emin3397/EE464-Project/README.md

# EE464-Project
Emin Ün-Emre Karabakla-Görkem Gülletutan

Rapor: 
https://docs.google.com/document/d/1F6ZsHuH_-bDFWWwnSLHJ_5yXT3tPWivFNy6Llo1I6zs/edit#heading=h.hhpnnwzfyg3q

Sunum:
https://docs.google.com/presentation/d/1tMdv5Q-z6gMAUCtrlJFETEWXZ9VnNtSR/edit#slide=id.p1
