emin3397/EE464-Project/PCB/main/main-Edge_Cuts.dxf

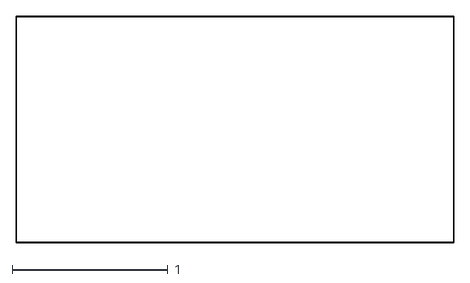
[picture p25: CAD file, 2021-05-06]
PCB/main/main-Edge_Cuts.dxf
2.81 x 1.45
