emin3397/EE464-Project/PCB/main_backup/main-B_Cu.dxf

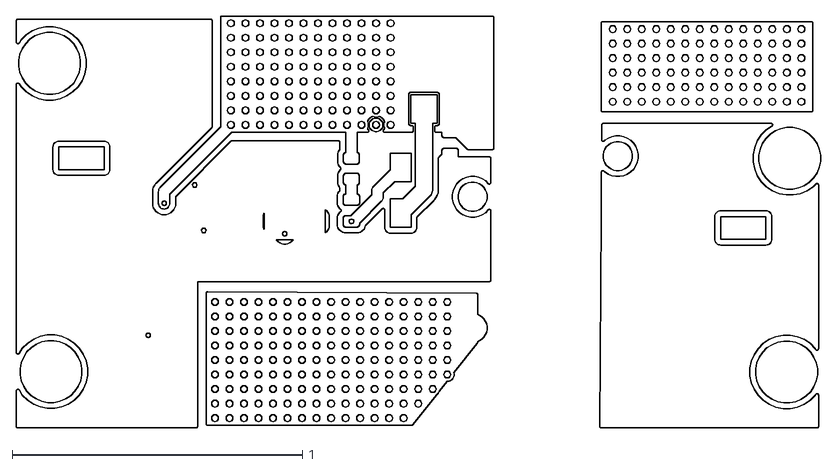
[picture p26: CAD file, 2021-05-06]
PCB/main_backup/main-B_Cu.dxf
2.77 x 1.42
