emin3397/EE464-Project/PCB/main/main-F_Cu.dxf

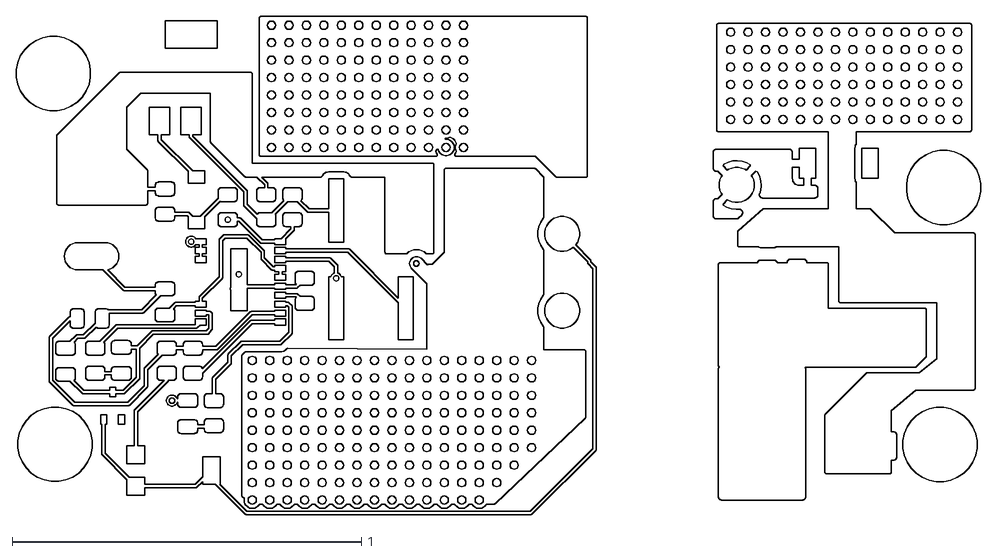
[picture p27: CAD file, 2021-05-06]
PCB/main/main-F_Cu.dxf
2.76 x 1.43
