emin3397/EE464-Project/PCB/main/solidworks/full_montaj.SLDASM

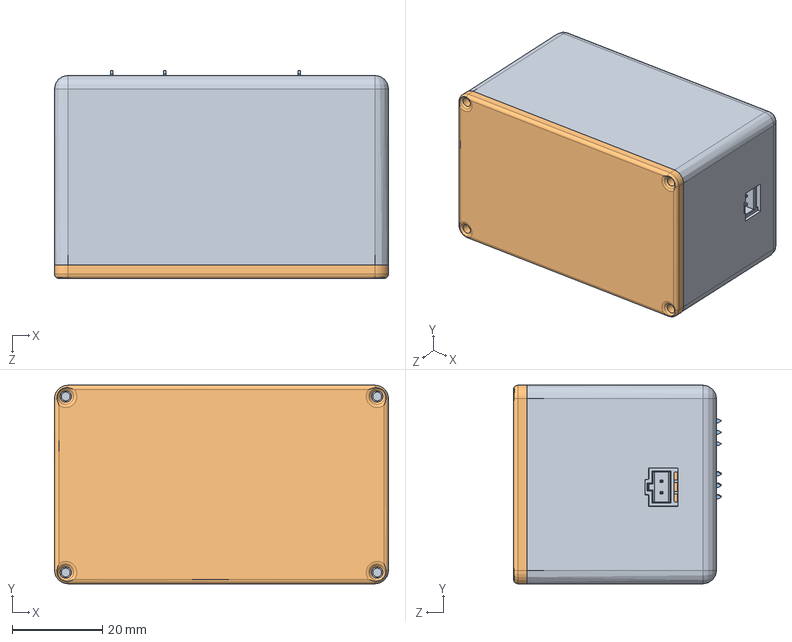
[picture p28: CAD file, 2021-07-01]
PCB/main/solidworks/full_montaj.SLDASM
74.0 x 44.0 x 46.1 mm
COMPOUND.step x 2
SOLID.step x 3
SOLID-0.step x 9
SOLID-1.step
SOLID-2.step
SOLID-3.step
SOLID-4.step x 11
SOLID-5.step
SOLID-6.step x 8
COMPOUND-7.step
SOLID-8.step
SOLID-9.step
SOLID-10.step
SOLID-11.step
COMPOUND-12.step
power_connector x 2
