emin3397/EE464-Project/PCB/main/solidworks/main.SLDASM

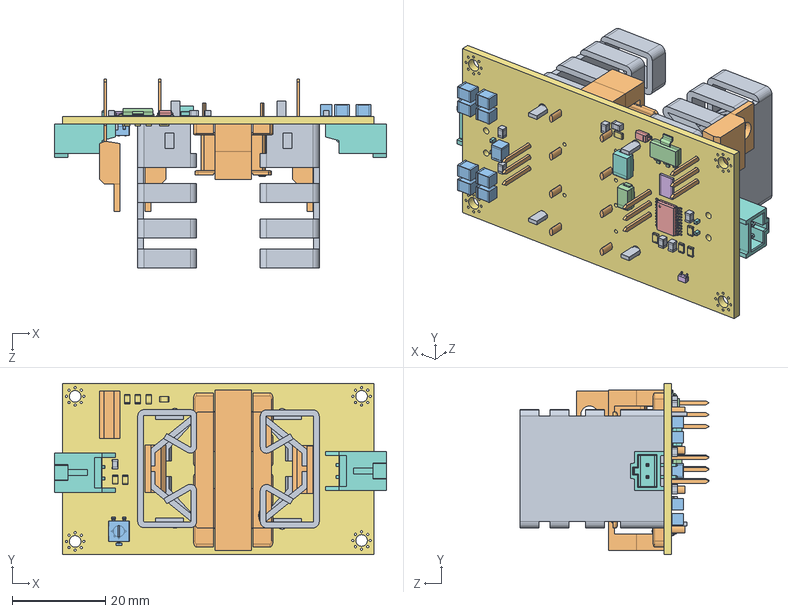
[picture p29: CAD file, 2021-07-01]
PCB/main/solidworks/main.SLDASM
71.4 x 36.8 x 40.8 mm
COMPOUND.step x 2
SOLID.step x 3
SOLID-0.step x 9
SOLID-1.step
SOLID-2.step
SOLID-3.step
SOLID-4.step x 11
SOLID-5.step
SOLID-6.step x 8
COMPOUND-7.step
SOLID-8.step
SOLID-9.step
SOLID-10.step
SOLID-11.step
COMPOUND-12.step
power_connector x 2
