emin3397/EE464-Project/PCB/main_backup/solidworks/full_copper.SLDASM

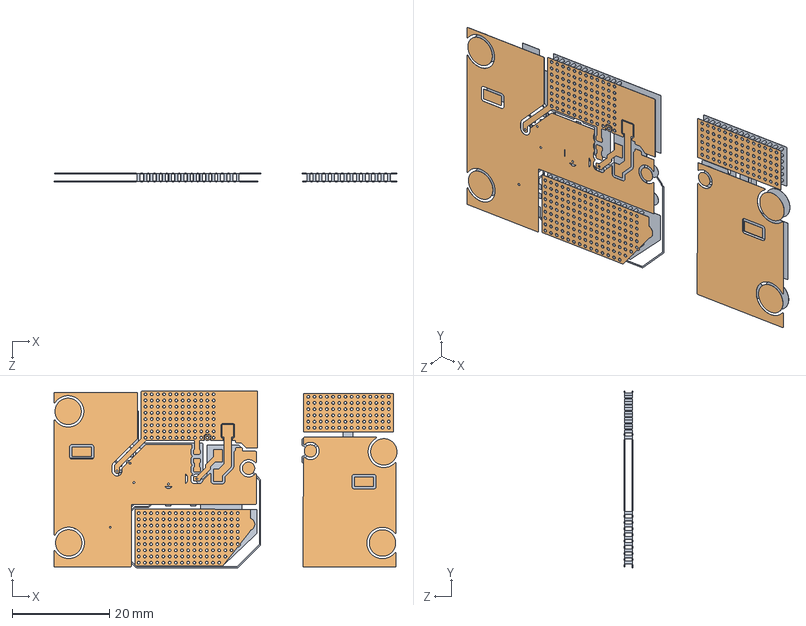
[picture p30: CAD file, 2021-05-06]
PCB/main_backup/solidworks/full_copper.SLDASM
70.4 x 36.2 x 1.67 mm
Front_copper
Back_copper
