emin3397/EE464-Project/PCB/main_backup/solidworks/main.SLDASM

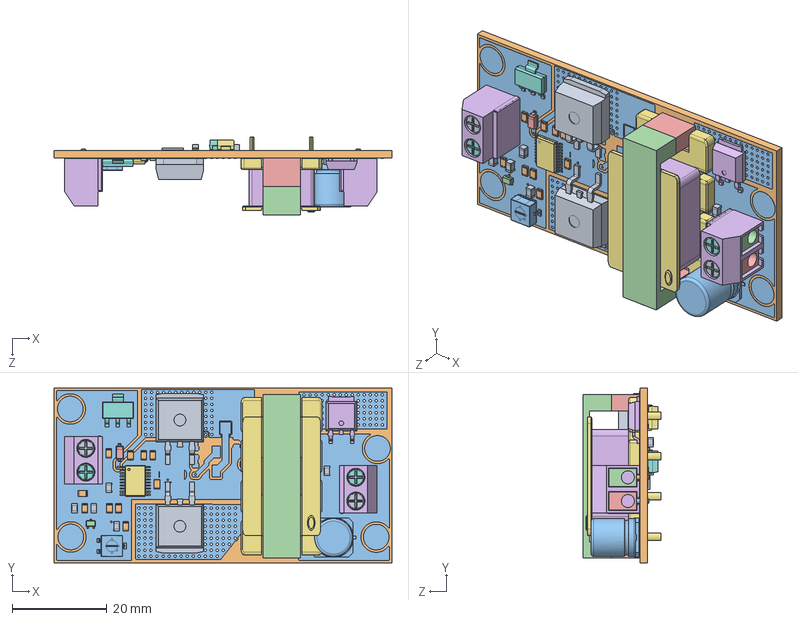
[picture p31: CAD file, 2021-05-06]
PCB/main_backup/solidworks/main.SLDASM
71.2 x 36.8 x 16.4 mm
full_copper
