emin3397/EE464-Project/PCB/main/solidworks/box.SLDPRT

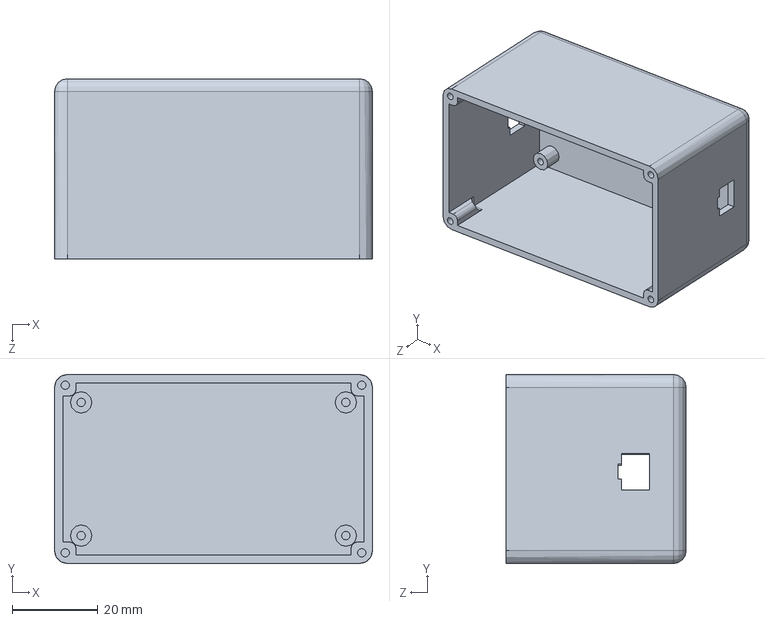
[picture p32: CAD file, 2021-07-01]
PCB/main/solidworks/box.SLDPRT
74.0 x 44.0 x 42.0 mm
