emin3397/EE464-Project/PCB/power_connector.stp

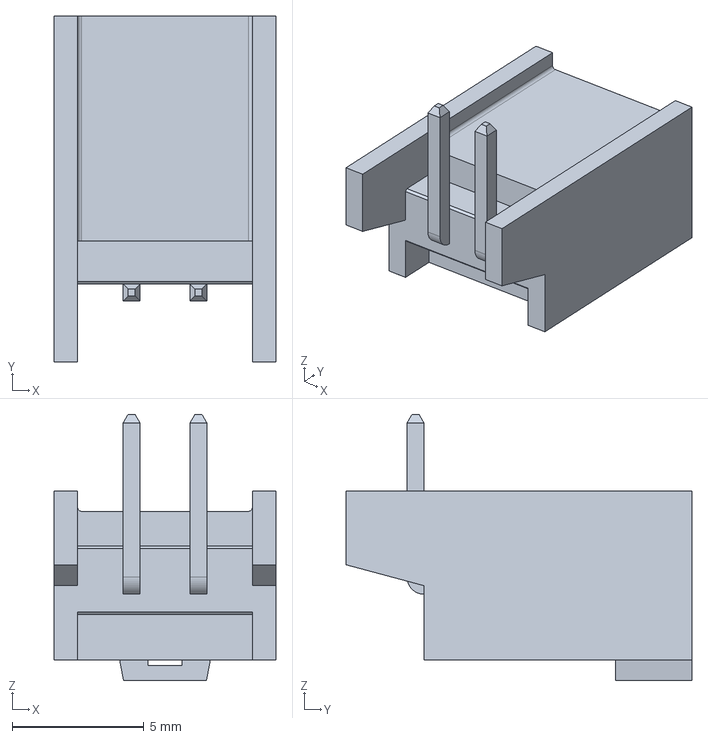
[picture p33: CAD file, 2021-07-01]
PCB/power_connector.stp
8.43 x 13.1 x 10.1 mm
