emin3397/EE464-Project/PCB/fk_241_sa_218_v.stp

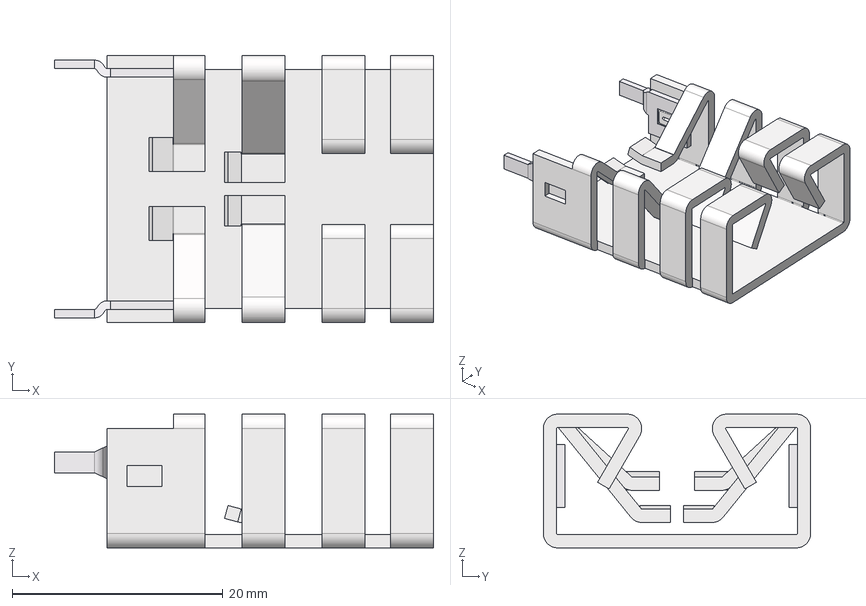
[picture p34: CAD file, 2021-05-06]
PCB/fk_241_sa_218_v.stp
36.0 x 25.4 x 12.7 mm
