emin3397/EE464-Project/PCB/main/solidworks/box_lid.SLDPRT

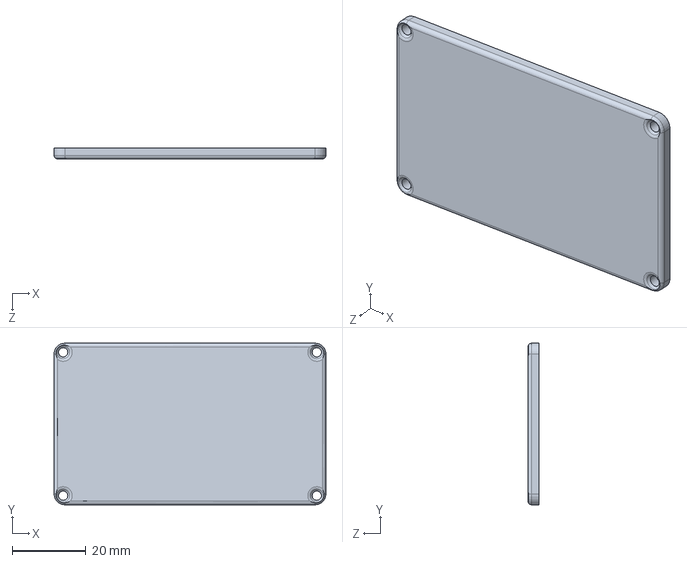
[picture p35: CAD file, 2021-07-01]
PCB/main/solidworks/box_lid.SLDPRT
74.0 x 44.0 x 3.00 mm
