emin3397/EE464-Project/PCB/Transformer.STEP

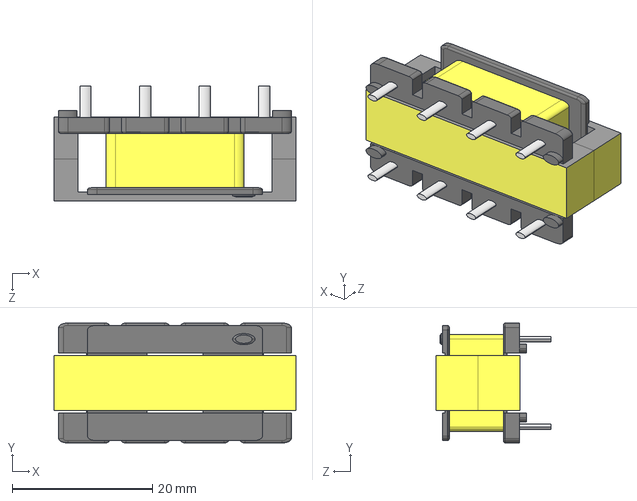
[picture p36: CAD file, 2021-05-01]
PCB/Transformer.STEP
34.5 x 17.1 x 16.4 mm
