emin3397/EE464-Project/PCB/main_backup/solidworks/COMPOUND.SLDPRT

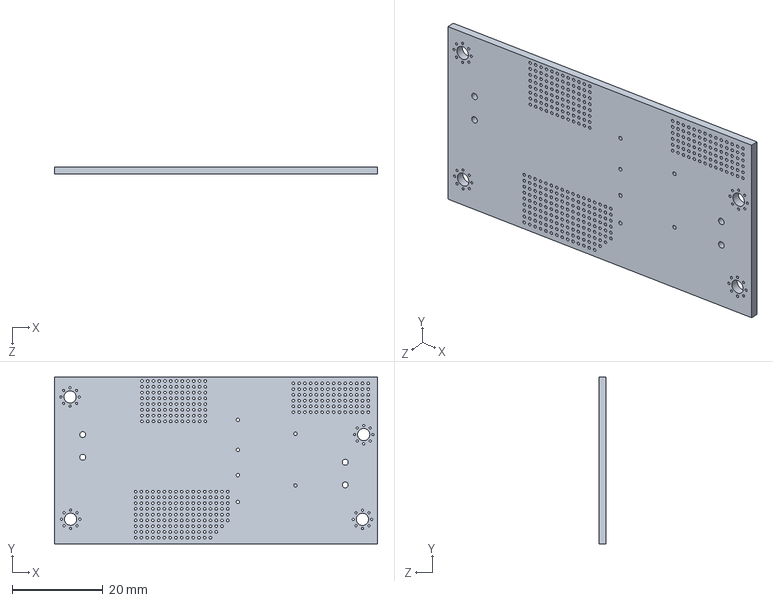
[picture p37: CAD file, 2021-05-06]
PCB/main_backup/solidworks/COMPOUND.SLDPRT
71.2 x 36.8 x 1.60 mm
