emin3397/EE464-Project/PCB/main_backup/solidworks/Front_copper.SLDPRT

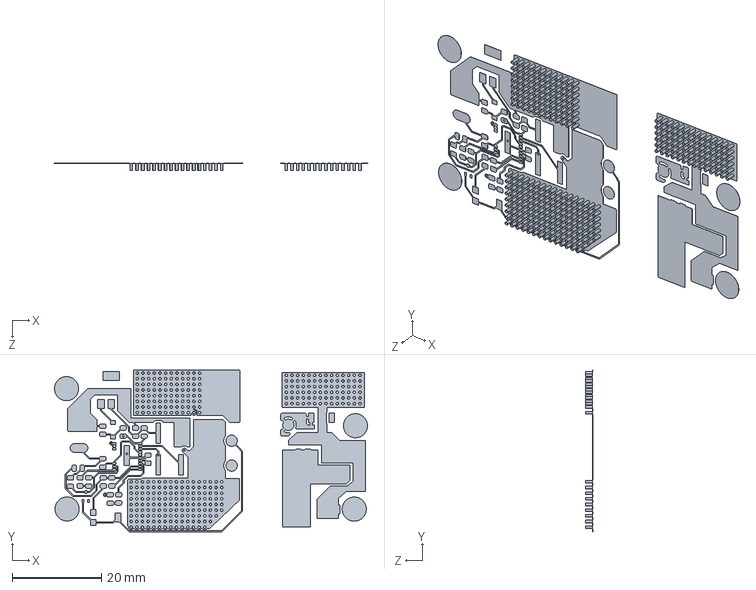
[picture p38: CAD file, 2021-05-06]
PCB/main_backup/solidworks/Front_copper.SLDPRT
70.2 x 36.2 x 1.67 mm
