emin3397/EE464-Project/PCB/main_backup/solidworks/Back_copper.SLDPRT

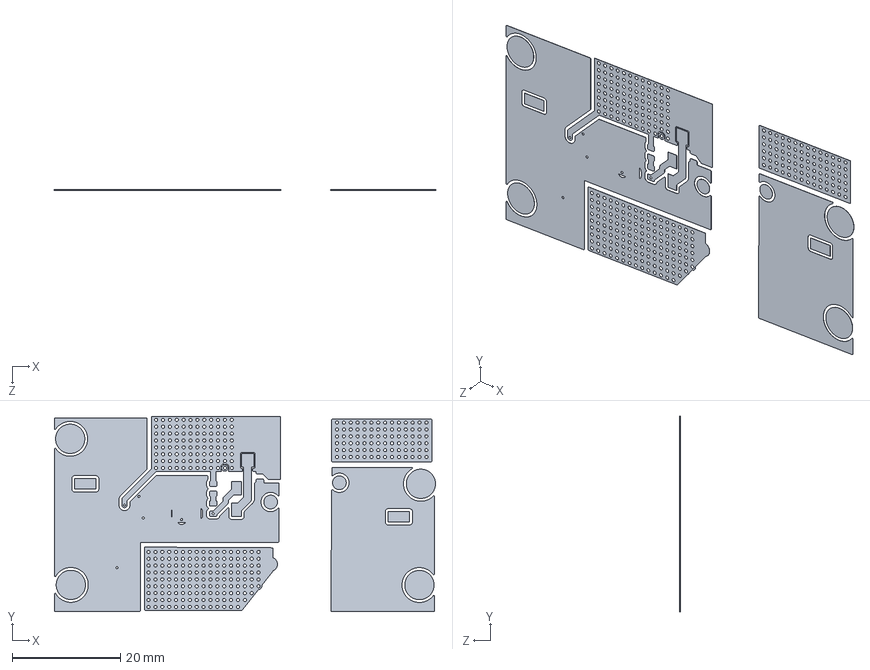
[picture p39: CAD file, 2021-05-06]
PCB/main_backup/solidworks/Back_copper.SLDPRT
70.4 x 36.0 x 0.035 mm
