emin3397/EE464-Project/(list of files, cad)

Other CAD files:
PCB/main_backup/solidworks/SOT-223.SLDASM
PCB/main_backup/solidworks/D_SOD-123.SLDASM
PCB/main_backup/solidworks/C_Elec_8x10.2-subassembly-1.SLDASM
PCB/main_backup/solidworks/Potentiometer_Bourns_3314G_Vertical.SLDASM
PCB/main_backup/solidworks/Transformer.SLDASM
PCB/main_backup/solidworks/Transformer-subassembly-1.SLDASM
PCB/main_backup/solidworks/SOT-323_SC-70.SLDASM
PCB/main_backup/solidworks/R_1218_3246Metric.SLDASM
PCB/main_backup/solidworks/C_0805_2012Metric.SLDASM
PCB/main_backup/solidworks/D_SMA.SLDASM
PCB/main_backup/solidworks/TO-252-2.SLDASM
PCB/main_backup/solidworks/C_Elec_8x10.2.SLDASM
PCB/main_backup/solidworks/R_0805_2012Metric.SLDASM
PCB/main_backup/solidworks/TSSOP-20_4.4x6.5mm_P0.65mm.SLDASM
PCB/main_backup/solidworks/D_SMB.SLDASM
PCB/main_backup/solidworks/TO-263-2.SLDASM
PCB/main_backup/solidworks/COMPOUND-5.SLDPRT
PCB/main_backup/solidworks/COMPOUND-8.SLDPRT
PCB/main_backup/solidworks/SOLID-9.SLDPRT
PCB/main/solidworks/power_connector.SLDPRT
PCB/main_backup/solidworks/SOLID-7.SLDPRT
PCB/main_backup/solidworks/COMPOUND-4.SLDPRT
PCB/main_backup/solidworks/COMPOUND-9.SLDPRT
PCB/main_backup/solidworks/COMPOUND-13.SLDPRT
PCB/main_backup/solidworks/COMPOUND-12.SLDPRT
PCB/main_backup/solidworks/COMPOUND-6.SLDPRT
PCB/main_backup/solidworks/SOLID-4.SLDPRT
PCB/main_backup/solidworks/COMPOUND-3.SLDPRT
PCB/main_backup/solidworks/COMPOUND-2.SLDPRT
PCB/main_backup/solidworks/SOLID-8.SLDPRT
PCB/main_backup/solidworks/SOLID.SLDPRT
PCB/main_backup/solidworks/SOLID-3.SLDPRT
PCB/main_backup/solidworks/SOLID-1.SLDPRT
PCB/main_backup/solidworks/SOLID-2.SLDPRT
PCB/main_backup/solidworks/SOLID-11.SLDPRT
PCB/main_backup/solidworks/COMPOUND-7.SLDPRT
PCB/main_backup/solidworks/COMPOUND-1.SLDPRT
PCB/main_backup/solidworks/SOLID-6.SLDPRT
PCB/main_backup/solidworks/COMPOUND-10.SLDPRT
PCB/main_backup/solidworks/COMPOUND-11.SLDPRT
PCB/main_backup/solidworks/SOLID-10.SLDPRT
PCB/main_backup/solidworks/SOLID-5.SLDPRT
PCB/main/main-B_Mask.dxf
PCB/main/main-B_Paste.dxf
PCB/main/main-B_SilkS.dxf
PCB/main/main-F_Mask.dxf
PCB/main/main-F_Paste.dxf
PCB/main/main-F_SilkS.dxf
PCB/main/solidworks_old/COMPOUND-1.SLDPRT
PCB/main/solidworks_old/COMPOUND-10.SLDPRT
PCB/main/solidworks_old/COMPOUND-11.SLDPRT
PCB/main/solidworks_old/COMPOUND-12.SLDPRT
PCB/main/solidworks_old/COMPOUND-13.SLDPRT
PCB/main/solidworks_old/COMPOUND-2.SLDPRT
PCB/main/solidworks_old/COMPOUND-3.SLDPRT
PCB/main/solidworks_old/COMPOUND-4.SLDPRT
PCB/main/solidworks_old/COMPOUND-5.SLDPRT
PCB/main/solidworks_old/COMPOUND-6.SLDPRT
PCB/main/solidworks_old/COMPOUND-7.SLDPRT
PCB/main/solidworks_old/COMPOUND-8.SLDPRT
PCB/main/solidworks_old/COMPOUND-9.SLDPRT
PCB/main/solidworks_old/C_0805_2012Metric.SLDASM
PCB/main/solidworks_old/C_Elec_8x10.2-subassembly-1.SLDASM
PCB/main/solidworks_old/C_Elec_8x10.2.SLDASM
PCB/main/solidworks_old/D_SMA.SLDASM
PCB/main/solidworks_old/D_SMB.SLDASM
PCB/main/solidworks_old/D_SOD-123.SLDASM
PCB/main/solidworks_old/Potentiometer_Bourns_3314G_Vertical.SLDASM
PCB/main/solidworks_old/R_0805_2012Metric.SLDASM
PCB/main/solidworks_old/R_1218_3246Metric.SLDASM
PCB/main/solidworks_old/SOLID-1.SLDPRT
PCB/main/solidworks_old/SOLID-10.SLDPRT
PCB/main/solidworks_old/SOLID-11.SLDPRT
PCB/main/solidworks_old/SOLID-2.SLDPRT
PCB/main/solidworks_old/SOLID-3.SLDPRT
PCB/main/solidworks_old/SOLID-4.SLDPRT
PCB/main/solidworks_old/SOLID-5.SLDPRT
PCB/main/solidworks_old/SOLID-6.SLDPRT
PCB/main/solidworks_old/SOLID-7.SLDPRT
PCB/main/solidworks_old/SOLID-8.SLDPRT
PCB/main/solidworks_old/SOLID-9.SLDPRT
PCB/main/solidworks_old/SOLID.SLDPRT
PCB/main/solidworks_old/SOT-223.SLDASM
PCB/main/solidworks_old/SOT-323_SC-70.SLDASM
PCB/main/solidworks_old/Screw_Terminal_Block_5mm_2-way-subassembly-1.SLDASM
PCB/main/solidworks_old/Screw_Terminal_Block_5mm_2-way.SLDASM
PCB/main/solidworks_old/TO-252-2.SLDASM
PCB/main/solidworks_old/TO-263-2.SLDASM
PCB/main/solidworks_old/TSSOP-20_4.4x6.5mm_P0.65mm.SLDASM
PCB/main/solidworks_old/Transformer-subassembly-1.SLDASM
PCB/main/solidworks_old/Transformer.SLDASM
PCB/main_backup/main-B_Mask.dxf
PCB/main_backup/main-B_Paste.dxf
PCB/main_backup/main-B_SilkS.dxf
PCB/main_backup/main-F_Mask.dxf
PCB/main_backup/main-F_Paste.dxf
PCB/main_backup/main-F_SilkS.dxf
PCB/main_backup/solidworks/Screw_Terminal_Block_5mm_2-way-subassembly-1.SLDASM
PCB/main_backup/solidworks/Screw_Terminal_Block_5mm_2-way.SLDASM
