emin3397/EE464-Project/PCB/main/solidworks/PerformanceLog.txt

Number of Contacts: 2
Number of contact data: 8265
