emin3397/EE464-Project/PCB/main_backup/solidworks/PerformanceLog.txt

Number of Contacts: 3
Number of contact data: 8403
