emin3397/EE464-Project/Circuits/Flyback_LT8316.asc

C1: cap; 100nf
C3: cap; 47p; Rser=10K
C5: cap; 1µ
C7: cap; 1n; Rser=25
C8: cap; 200µ; Rser=2m
C9: cap; 100n; Rser=20K
D2: schottky; RB058L150
D3: diode; STD12100TR
D4: diode; RFN1L7S
D5: zener; 1N5378B; N=2
L1: ind2; 380µ; Rser=0.5
L2: ind2; 2.63µ; Rser=0.03 Cpar=0.5p
L3: ind2; 2.63µ; Rser=0.6
M1: NMOS; IPU80R2K8CEBKMA1
M2: NMOS; BSB012N03LX3
R4: res; 108K
R5: res; 18.7k
R6: res; 2.2k
R9: res; 61.9K
Rload1: res; 1.55
Rload: res; 14.4
Rsense: res; 20m
U1: LT8316
Vin1: voltage; PULSE(0 12 25m 1p 1p 5m 10m)
Vin: voltage; 400
Named nets: 0, IN, OUT, G, D, S
K1 L1 L2 L3 0.993
12:1:1
.tran 20m 40m 0 20u startup uic
.model STD12100TR D(Vrev=100 Vf=0.75)
.model IPU80R2K8CEBKMA1 VDMOS(Rg=1.2 Cjo=.29n Vds=800 Ron=2.8 Qg=12n)
.model SW SW()
