emin3397/EE464-Project/PCB/main/main.kicad_pcb

## KiCad design PCB/main/main.kicad_pcb (2021-07-01)

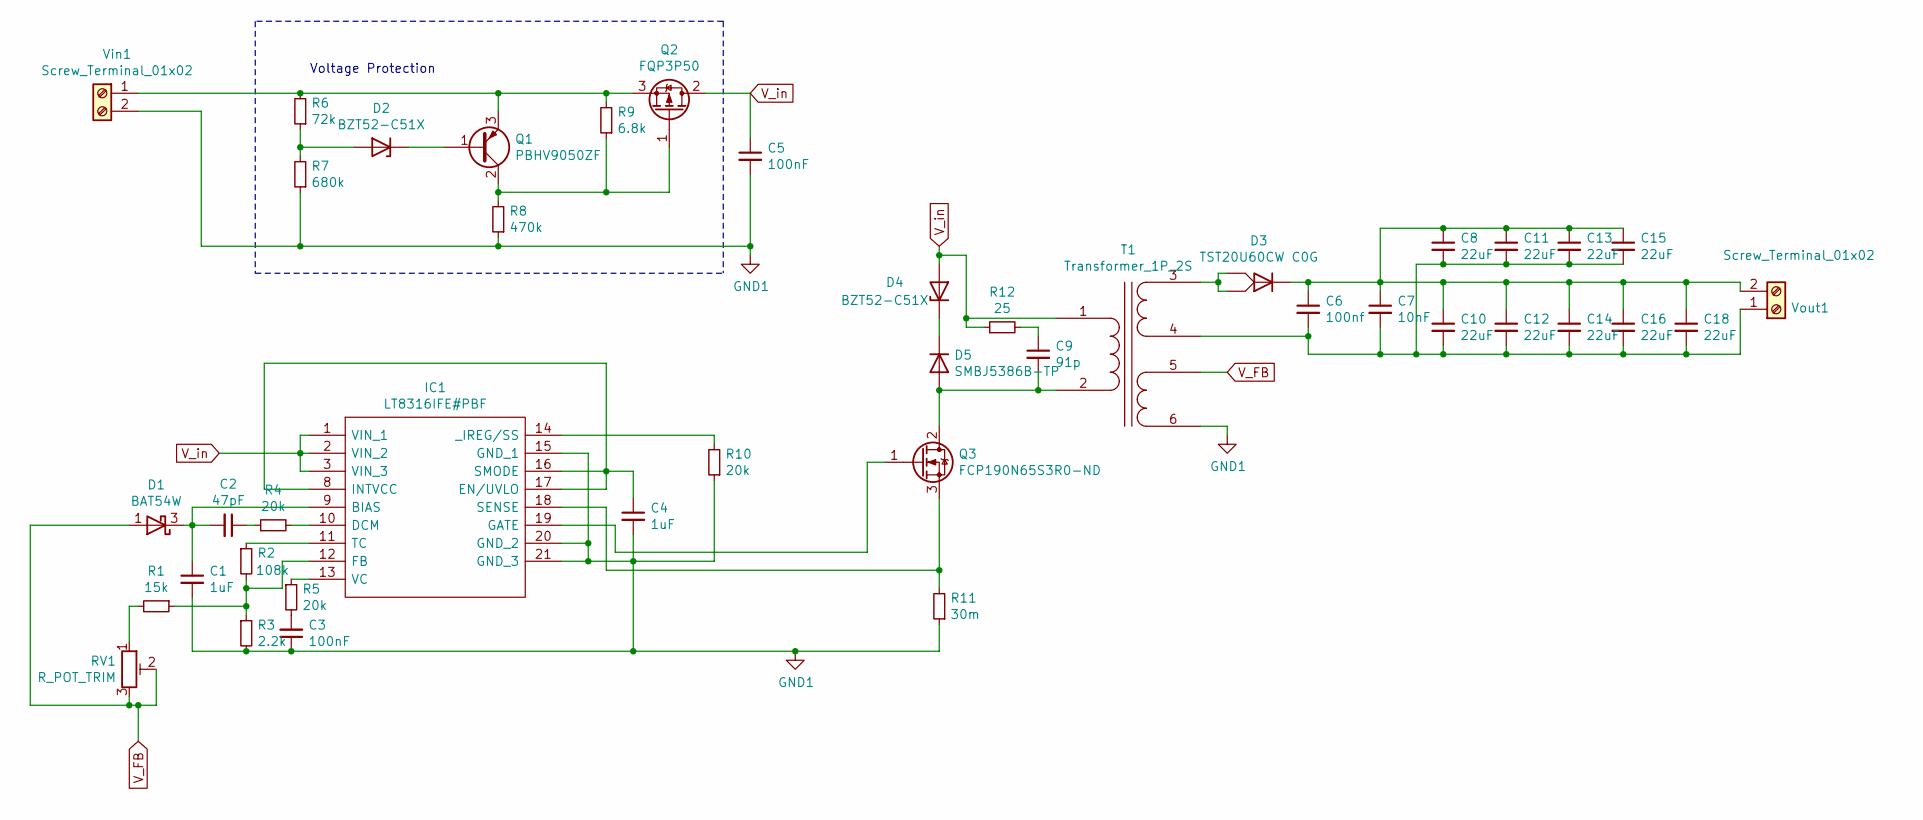
[picture p40: schematic main.sch]

Parts:
C1, C4: 1uF; C_0805_2012Metric
C2: 47pF; C_0805_2012Metric
C3, C5: 100nF; C_0805_2012Metric
C6: 100nf; C_0805_2012Metric
C7: 10nF; C_0805_2012Metric
C8, C10, C11, C12, C13, C14, C15, C16, C18: 22uF; C_1210_3225Metric
C9: 91p; C_0805_2012Metric
D1: BAT54W; SOT-323_SC-70
D2: BZT52-C51X; D_SOD-123
D3: TST20U60CW C0G; TO-220-3_Vertical
D4: BZT52-C51X; D_SMB
D5: SMBJ5386B-TP; D_SMA
IC1: LT8316IFE#PBF; LT8316IFEPBF; Manufacturer_Part_Number LT8316IFE#PBF; Mouser Part Number 584-LT8316IFE#PBF
Q1: PBHV9050ZF; SOT-223-3_TabPin2
Q2: FQP3P50; TO-220-3_Vertical
Q3: FCP190N65S3R0-ND; TO-220-3_Vertical
R1: 15k; R_0805_2012Metric
R2: 108k; R_0805_2012Metric
R3: 2.2k; R_0805_2012Metric
R4, R5, R10: 20k; R_0805_2012Metric
R6: 72k; R_0805_2012Metric
R7: 680k; R_0805_2012Metric
R8: 470k; R_0805_2012Metric
R9: 6.8k; R_0805_2012Metric
R11: 30m; R_1218_3246Metric_Pad1.22x4.75mm_HandSolder
R12: 25; R_0805_2012Metric
RV1: R_POT_TRIM; Potentiometer_Bourns_3314G_Vertical
T1: Transformer_1P_2S; EE464_Transformer
Vin1: Screw_Terminal_01x02; TerminalBlock_Altech_AK300-2_P5.00mm
Vout1: Screw_Terminal_01x02; TerminalBlock_Altech_AK300-2_P5.00mm

Connections:
GND1: C1.2, C3.1, C4.2, C5.2, IC1.15 (GND_1), IC1.20 (GND_2), IC1.21 (GND_3), R3.2, R7.1, R8.1, R10.1, R11.1, T1.6 (SD), Vin1.2
unnamed: C1.1, C2.2, D1.3 (K), IC1.9 (BIAS)
unnamed: C2.1, R4.1
unnamed: C3.2, R5.2
unnamed: C4.1, IC1.8 (INTVCC), IC1.16 (SMODE), IC1.17 (EN/UVLO)
unnamed: C9.1, R12.2
unnamed: C9.2, D5.1 (A), Q3.2 (D), T1.2 (AB)
unnamed: C6.1, C7.1, C8.1, C10.1, C11.1, C12.1, C13.1, C14.1, C15.1, C16.1, C18.1, D3.2 (K), Vout1.2
unnamed: C6.2, C7.2, C8.2, C10.2, C11.2, C12.2, C13.2, C14.2, C15.2, C16.2, C18.2, T1.4 (SB), Vout1.1
unnamed: D2.1 (K), Q1.1 (B)
unnamed: D2.2 (A), R6.1, R7.2
unnamed: D3.1 (A), D3.3 (A), T1.3 (SA)
unnamed: D4.1 (K), D5.2 (K)
unnamed: IC1.10 (DCM), R4.2
unnamed: IC1.11 (TC), R2.1
unnamed: IC1.12 (FB), R1.1, R2.2, R3.1
unnamed: IC1.13 (VC), R5.1
unnamed: IC1.14 (_IREG/SS), R10.2
unnamed: IC1.18 (SENSE), Q3.3 (S), R11.2
unnamed: IC1.19 (GATE), Q3.1 (G)
unnamed: Q1.2 (C), Q2.1 (G), R8.2, R9.1
unnamed: Q1.3 (E), Q2.3 (S), R6.2, R9.2, Vin1.1
unnamed: R1.2, RV1.1
V_FB: D1.1 (A), RV1.2, RV1.3, T1.5 (SC)
V_in: C5.1, D4.2 (A), IC1.1 (VIN_1), IC1.2 (VIN_2), IC1.3 (VIN_3), Q2.2 (D), R12.1, T1.1 (AA)

Notes on the sheet:
Voltage Protection

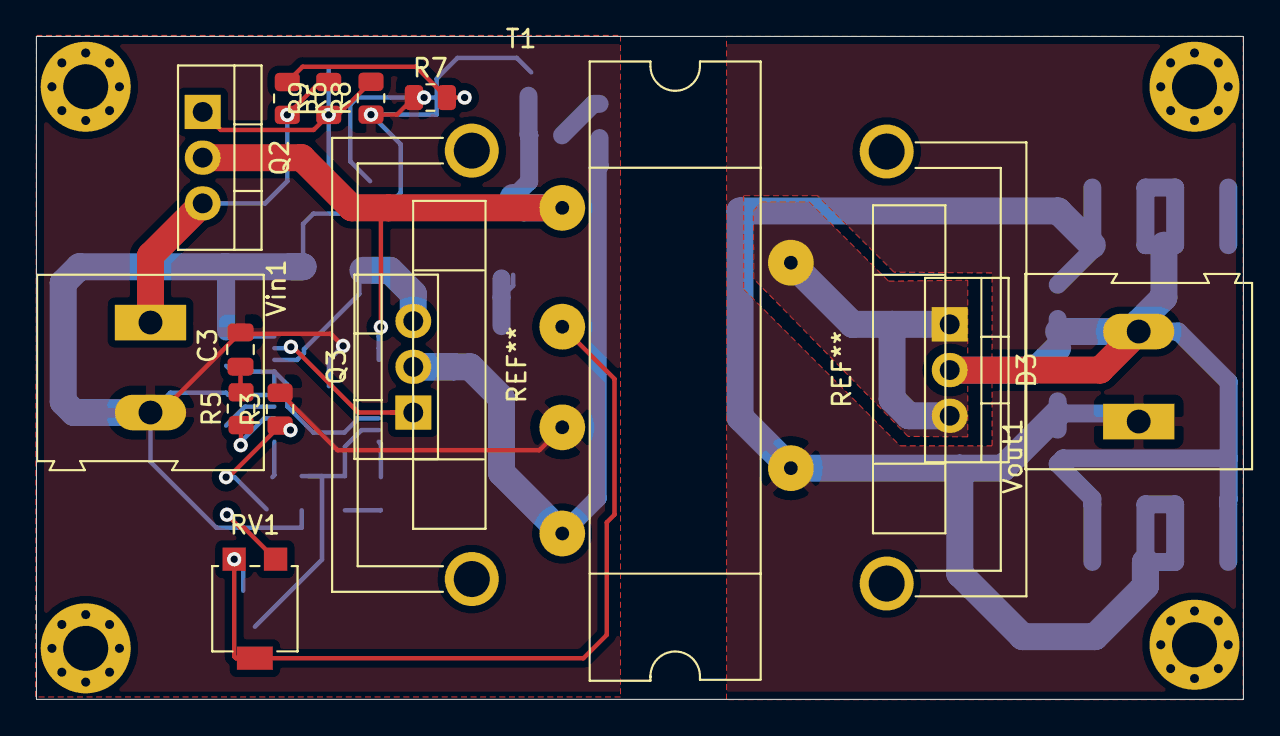
[picture p41: board main.kicad_pcb from above]

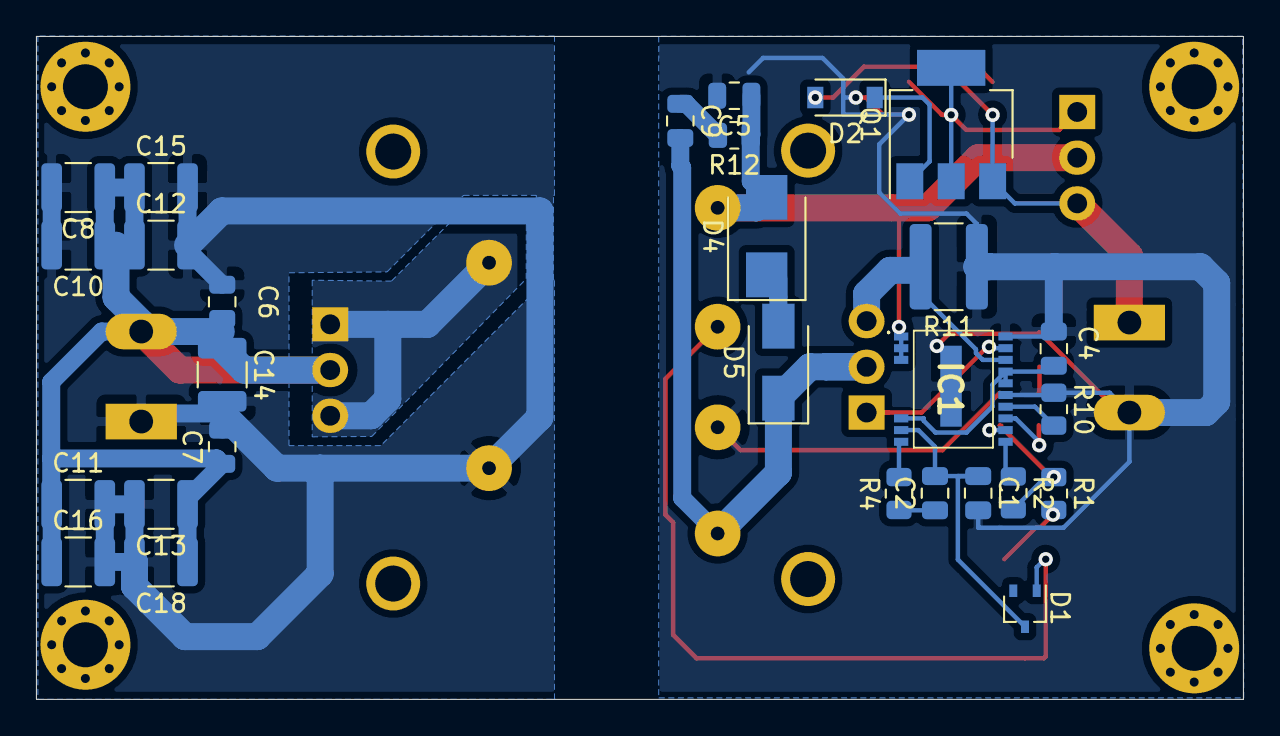
[picture p42: board main.kicad_pcb from below]

Board: 2 copper layers, 67.1 x 36.8 mm, 42 parts (28 on the bottom side), 25 nets.
