emin3397/EE464-Project/(commit log)

2021-04-28 protection circuit design
2021-04-29 Component Selection is added.
    [Component Selection.xlsx]
2021-04-30 The design is updated. (Sense resistance, output capacitance and transformer inductances are changed.)
2021-05-01 PCB drawing, components update
    [Component Selection.xlsx, Transformer.STEP, main.kicad_pcb, main.sch]
2021-05-02 pcb drawing update
    [Component Selection.xlsx, main.kicad_pcb]
2021-05-02 Component selection is updated.
    [Component Selection.xlsx]
2021-05-06 PCB updated with new mosfet&diode
    [Back_copper.SLDPRT, COMPOUND-1.SLDPRT, COMPOUND-10.SLDPRT, COMPOUND-11.SLDPRT, COMPOUND-12.SLDPRT, COMPOUND-13.SLDPRT, COMPOUND-2.SLDPRT, COMPOUND-3.SLDPRT]
2021-05-07 Power losses and thermal analysis for Diode and MOSFET is completed.
2021-05-07 script and pcb updated
    [main.kicad_pcb, main.sch]
2021-07-01 Thermal simulation and box drawing
    [Back_copper.SLDPRT, COMPOUND-1.SLDPRT, COMPOUND-10.SLDPRT, COMPOUND-11.SLDPRT, COMPOUND-12.SLDPRT, COMPOUND-13.SLDPRT, COMPOUND-2.SLDPRT, COMPOUND-3.SLDPRT]
